ferrglez/solips-hmi-controller/SOLIPS_HMI_CONTROLLER_REV_A/report.txt

Info: Procesando el símbolo 'C1:Capacitor_SMD:C_0805_2012Metric'.
Info: Procesando el símbolo 'R2:Resistor_SMD:R_0603_1608Metric'.
Info: Procesando el símbolo 'C10:Capacitor_SMD:C_0805_2012Metric'.
Info: Procesando el símbolo 'J3:Connector_USB:USB_C_Receptacle_Amphenol_124019772112A'.
Info: Procesando el símbolo 'C4:Capacitor_SMD:C_0603_1608Metric'.
Info: Procesando el símbolo 'R1:Resistor_SMD:R_0603_1608Metric'.
Info: Procesando el símbolo 'C11:Capacitor_SMD:C_1206_3216Metric'.
Info: Procesando el símbolo 'J1:Connector_PinHeader_2.54mm:PinHeader_1x05_P2.54mm_Vertical'.
Info: Procesando el símbolo 'R4:Resistor_SMD:R_0603_1608Metric'.
Info: Procesando el símbolo 'C3:Capacitor_SMD:C_0603_1608Metric'.
Info: Procesando el símbolo 'R3:Resistor_SMD:R_0603_1608Metric'.
Info: Procesando el símbolo 'C12:Capacitor_SMD:C_0805_2012Metric'.
Info: Procesando el símbolo 'C7:Capacitor_SMD:C_0805_2012Metric'.
Info: Procesando el símbolo 'C8:Capacitor_SMD:C_0603_1608Metric'.
Info: Procesando el símbolo 'C2:Capacitor_SMD:C_0603_1608Metric'.
Info: Procesando el símbolo 'C6:Capacitor_SMD:C_0805_2012Metric'.
Info: Procesando el símbolo 'C9:Capacitor_SMD:C_0805_2012Metric'.
Info: Procesando el símbolo 'J4:Connector_PinHeader_2.54mm:PinHeader_1x07_P2.54mm_Vertical'.
Info: Procesando el símbolo 'C5:Capacitor_SMD:C_0603_1608Metric'.
Info: Procesando el símbolo 'R5:Resistor_SMD:R_0603_1608Metric'.
Info: Procesando el símbolo 'R6:Resistor_SMD:R_0603_1608Metric'.
Info: Procesando el símbolo 'R7:Resistor_SMD:R_0603_1608Metric'.
Info: Procesando el símbolo 'R8:Resistor_SMD:R_0603_1608Metric'.
Info: Procesando el símbolo 'SW1:Button_Switch_SMD:SW_SPST_TL3305A'.
Info: Procesando el símbolo 'SW2:Button_Switch_SMD:SW_SPST_TL3305A'.
Info: Procesando el símbolo 'TP1:TestPoint:TestPoint_Pad_D1.5mm'.
Info: Procesando el símbolo 'TP2:TestPoint:TestPoint_Pad_D1.5mm'.
Info: Procesando el símbolo 'U1:Package_QFP:LQFP-48_7x7mm_P0.5mm'.
Info: Procesando el símbolo 'U2:Package_DFN_QFN:WQFN-24-1EP_4x4mm_P0.5mm_EP2.45x2.45mm'.
Info: Procesando el símbolo 'U3:Package_TO_SOT_SMD:SOT-23-6'.
Info: Procesando el símbolo 'U4:Package_TO_SOT_SMD:SOT-23-5'.
Se actualizaron los metadatos de unidad de C1.
Agregado C2 (huella 'Capacitor_SMD:C_0603_1608Metric').
Indicador de referencia cambiado de REF** a C2.
Valor C2 cambiado de C_0603_1608Metric a 100nF.
Asociación de símbolos C2 actualizada de  a /c9596c98-fdf7-4d75-8495-f3fe434cbf88/4467eb84-ecfb-4cf1-84c4-427a7b52d25b.
Actualizar campos C2.
Se actualizó el nombre de la hoja C2 a '/03_MCu/'.
Se actualizó el archivo de hoja C2 a '03_MCU.kicad_sch'.
Se actualizaron los filtros de huella de C2 a 'C_*'.
C2 pin 2 conectado a GND.
Agregar red +3V3.
C2 pin 1 conectado a +3V3.
Se actualizaron los metadatos de unidad de C2.
Agregado C3 (huella 'Capacitor_SMD:C_0603_1608Metric').
Indicador de referencia cambiado de REF** a C3.
Valor C3 cambiado de C_0603_1608Metric a 100nF.
Asociación de símbolos C3 actualizada de  a /c9596c98-fdf7-4d75-8495-f3fe434cbf88/b110ddbe-f6ca-42ca-a978-9b14236cfb37.
Actualizar campos C3.
Se actualizó el nombre de la hoja C3 a '/03_MCu/'.
Se actualizó el archivo de hoja C3 a '03_MCU.kicad_sch'.
Se actualizaron los filtros de huella de C3 a 'C_*'.
C3 pin 2 conectado a GND.
C3 pin 1 conectado a +3V3.
Se actualizaron los metadatos de unidad de C3.
Agregado C4 (huella 'Capacitor_SMD:C_0603_1608Metric').
Indicador de referencia cambiado de REF** a C4.
Valor C4 cambiado de C_0603_1608Metric a 100nF.
Asociación de símbolos C4 actualizada de  a /c9596c98-fdf7-4d75-8495-f3fe434cbf88/4eccbd7d-c71d-49d9-a82d-66c9b8987479.
Actualizar campos C4.
Se actualizó el nombre de la hoja C4 a '/03_MCu/'.
Se actualizó el archivo de hoja C4 a '03_MCU.kicad_sch'.
Se actualizaron los filtros de huella de C4 a 'C_*'.
C4 pin 2 conectado a GND.
C4 pin 1 conectado a +3V3.
Se actualizaron los metadatos de unidad de C4.
Agregado C5 (huella 'Capacitor_SMD:C_0603_1608Metric').
Indicador de referencia cambiado de REF** a C5.
Valor C5 cambiado de C_0603_1608Metric a 100nF.
Asociación de símbolos C5 actualizada de  a /c9596c98-fdf7-4d75-8495-f3fe434cbf88/e27b0a31-f71d-4fdd-a2e6-24cbac124ba2.
Actualizar campos C5.
Se actualizó el nombre de la hoja C5 a '/03_MCu/'.
Se actualizó el archivo de hoja C5 a '03_MCU.kicad_sch'.
Se actualizaron los filtros de huella de C5 a 'C_*'.
C5 pin 1 conectado a +3V3.
C5 pin 2 conectado a GND.
Se actualizaron los metadatos de unidad de C5.
Agregado C6 (huella 'Capacitor_SMD:C_0805_2012Metric').
Indicador de referencia cambiado de REF** a C6.
Valor C6 cambiado de C_0805_2012Metric a 1uF.
Asociación de símbolos C6 actualizada de  a /c9596c98-fdf7-4d75-8495-f3fe434cbf88/558f496c-9939-44e3-b908-68f146186542.
Actualizar campos C6.
Se actualizó el nombre de la hoja C6 a '/03_MCu/'.
Se actualizó el archivo de hoja C6 a '03_MCU.kicad_sch'.
Se actualizaron los filtros de huella de C6 a 'C_*'.
C6 pin 2 conectado a GND.
C6 pin 1 conectado a +3V3.
Se actualizaron los metadatos de unidad de C6.
Agregado C7 (huella 'Capacitor_SMD:C_0805_2012Metric').
Indicador de referencia cambiado de REF** a C7.
Valor C7 cambiado de C_0805_2012Metric a 4.7uF.
Asociación de símbolos C7 actualizada de  a /10d1682a-05b3-42fa-9511-bffc82f69c43/6c540aa3-2eca-4c6d-95e5-621262be4033.
Actualizar campos C7.
Se actualizó el nombre de la hoja C7 a '/02_USB_UART/'.
Se actualizó el archivo de hoja C7 a '02_USB_UART.kicad_sch'.
Se actualizaron los filtros de huella de C7 a 'C_*'.
Agregar red Net-(U2-VDD).
C7 pin 1 conectado a Net-(U2-VDD).
C7 pin 2 conectado a GND.
Se actualizaron los metadatos de unidad de C7.
Agregado C8 (huella 'Capacitor_SMD:C_0603_1608Metric').
Indicador de referencia cambiado de REF** a C8.
Valor C8 cambiado de C_0603_1608Metric a 100nF.
Asociación de símbolos C8 actualizada de  a /10d1682a-05b3-42fa-9511-bffc82f69c43/0269db98-f0dd-4d1b-8dcd-9299b7fe84f5.
Actualizar campos C8.
Se actualizó el nombre de la hoja C8 a '/02_USB_UART/'.
Se actualizó el archivo de hoja C8 a '02_USB_UART.kicad_sch'.
Se actualizaron los filtros de huella de C8 a 'C_*'.
C8 pin 1 conectado a Net-(U2-VDD).
C8 pin 2 conectado a GND.
Se actualizaron los metadatos de unidad de C8.
Agregado C9 (huella 'Capacitor_SMD:C_0805_2012Metric').
Indicador de referencia cambiado de REF** a C9.
Valor C9 cambiado de C_0805_2012Metric a 1µF.
Asociación de símbolos C9 actualizada de  a /05ec0a5c-9647-4b40-9959-19c73f5866a7/4eaefc70-4bc0-49f3-a873-1f2ae664b8bd.
Actualizar campos C9.
Se actualizó el nombre de la hoja C9 a '/01_POWER/'.
Se actualizó el archivo de hoja C9 a '01_POWER.kicad_sch'.
Se actualizaron los filtros de huella de C9 a 'C_*'.
Agregar red /02_USB_UART/USB_5V.
C9 pin 1 conectado a /02_USB_UART/USB_5V.
C9 pin 2 conectado a GND.
Se actualizaron los metadatos de unidad de C9.
Agregado C10 (huella 'Capacitor_SMD:C_0805_2012Metric').
Indicador de referencia cambiado de REF** a C10.
Valor C10 cambiado de C_0805_2012Metric a 1µF.
Asociación de símbolos C10 actualizada de  a /05ec0a5c-9647-4b40-9959-19c73f5866a7/1309739f-1510-4438-ae39-c69c16b107db.
Actualizar campos C10.
Se actualizó el nombre de la hoja C10 a '/01_POWER/'.
Se actualizó el archivo de hoja C10 a '01_POWER.kicad_sch'.
Se actualizaron los filtros de huella de C10 a 'C_*'.
C10 pin 1 conectado a +3V3.
C10 pin 2 conectado a GND.
Se actualizaron los metadatos de unidad de C10.
Agregado C11 (huella 'Capacitor_SMD:C_1206_3216Metric').
Indicador de referencia cambiado de REF** a C11.
Valor C11 cambiado de C_1206_3216Metric a 10uF.
Asociación de símbolos C11 actualizada de  a /c9596c98-fdf7-4d75-8495-f3fe434cbf88/3b9706d6-e7e8-4725-ad99-d57124ee87f7.
Actualizar campos C11.
Se actualizó el nombre de la hoja C11 a '/03_MCu/'.
Se actualizó el archivo de hoja C11 a '03_MCU.kicad_sch'.
Se actualizaron los filtros de huella de C11 a 'C_*'.
C11 pin 1 conectado a +3V3.
C11 pin 2 conectado a GND.
Se actualizaron los metadatos de unidad de C11.
Agregado C12 (huella 'Capacitor_SMD:C_0805_2012Metric').
Indicador de referencia cambiado de REF** a C12.
Valor C12 cambiado de C_0805_2012Metric a 4.7 µF.
Asociación de símbolos C12 actualizada de  a /10d1682a-05b3-42fa-9511-bffc82f69c43/97adc146-8964-4bae-ac5f-eecab92c6020.
Actualizar campos C12.
Se actualizó el nombre de la hoja C12 a '/02_USB_UART/'.
Se actualizó el archivo de hoja C12 a '02_USB_UART.kicad_sch'.
Se actualizaron los filtros de huella de C12 a 'C_*'.
C12 pin 2 conectado a /02_USB_UART/USB_5V.
C12 pin 1 conectado a GND.
Se actualizaron los metadatos de unidad de C12.
Agregado J1 (huella 'Connector_PinHeader_2.54mm:PinHeader_1x05_P2.54mm_Vertical').
Indicador de referencia cambiado de REF** a J1.
Valor J1 cambiado de PinHeader_1x05_P2.54mm_Vertical a Conn_01x05.
Asociación de símbolos J1 actualizada de  a /52f34958-c7fc-4581-a423-01bfa8e8f7c7/80e87493-2f8c-48ec-b9cd-21fb4aaffa53.
Actualizar campos J1.
Se actualizó el nombre de la hoja J1 a '/05_DEBUG/'.
Se actualizó el archivo de hoja J1 a '05_DEBUG.kicad_sch'.
Se actualizaron los filtros de huella de J1 a 'Connector*:*_1x??_*'.
J1 pin 5 conectado a GND.
Agregar red /03_MCu/MCU_NRST.
J1 pin 3 conectado a /03_MCu/MCU_NRST.
J1 pin 1 conectado a +3V3.
J1 pin 4 conectado a /03_MCu/MCU_NRST.
Agregar red /03_MCu/MCU_SWDIO.
J1 pin 2 conectado a /03_MCu/MCU_SWDIO.
Se actualizaron los metadatos de unidad de J1.
Agregado J3 (huella 'Connector_USB:USB_C_Receptacle_Amphenol_124019772112A').
Indicador de referencia cambiado de REF** a J3.
Valor J3 cambiado de USB_C_Receptacle_Amphenol_124019772112A a USB_C_Receptacle_USB2.0_16P.
Asociación de símbolos J3 actualizada de  a /10d1682a-05b3-42fa-9511-bffc82f69c43/e2037769-6a5f-4891-9a21-10af92cf296b.
Actualizar campos J3.
Se actualizó el nombre de la hoja J3 a '/02_USB_UART/'.
Se actualizó el archivo de hoja J3 a '02_USB_UART.kicad_sch'.
Se actualizaron los filtros de huella de J3 a 'USB*C*Receptacle*'.
Agregar red Net-(J3-SHIELD).
J3 pin SH conectado a Net-(J3-SHIELD).
J3 pin A12 conectado a GND.
Agregar red /02_USB_UART/USB_DP_RAW.
J3 pin A6 conectado a /02_USB_UART/USB_DP_RAW.
J3 pin B4 conectado a /02_USB_UART/USB_5V.
J3 pin SH conectado a Net-(J3-SHIELD).
J3 pin B12 conectado a GND.
J3 pin B1 conectado a GND.
J3 pin SH conectado a Net-(J3-SHIELD).
J3 pin A1 conectado a GND.
J3 pin B9 conectado a /02_USB_UART/USB_5V.
J3 pin A1 conectado a GND.
Agregar red /02_USB_UART/USB_DM_RAW.
J3 pin B7 conectado a /02_USB_UART/USB_DM_RAW.
Agregar red Net-(J3-CC2).
J3 pin B5 conectado a Net-(J3-CC2).
J3 pin A4 conectado a /02_USB_UART/USB_5V.
J3 pin B6 conectado a /02_USB_UART/USB_DP_RAW.
J3 pin A7 conectado a /02_USB_UART/USB_DM_RAW.
Agregar red unconnected-(J3-SBU1-PadA8).
J3 pin A8 conectado a unconnected-(J3-SBU1-PadA8).
Agregar red Net-(J3-CC1).
J3 pin A5 conectado a Net-(J3-CC1).
J3 pin A9 conectado a /02_USB_UART/USB_5V.
J3 pin A1 conectado a GND.
Agregar red unconnected-(J3-SBU2-PadB8).
J3 pin B8 conectado a unconnected-(J3-SBU2-PadB8).
J3 pin SH conectado a Net-(J3-SHIELD).
Se actualizaron los metadatos de unidad de J3.
Agregado J4 (huella 'Connector_PinHeader_2.54mm:PinHeader_1x07_P2.54mm_Vertical').
Indicador de referencia cambiado de REF** a J4.
Valor J4 cambiado de PinHeader_1x07_P2.54mm_Vertical a Conn_01x07.
Asociación de símbolos J4 actualizada de  a /36965fbf-a33d-4165-b521-3099ad8b80c5/500bb09e-58cf-4d2a-8b7e-7a604f7db37f.
Actualizar campos J4.
Se actualizó el nombre de la hoja J4 a '/04_DISPLAY/'.
Se actualizó el archivo de hoja J4 a '04_DISPLAY.kicad_sch'.
Se actualizaron los filtros de huella de J4 a 'Connector*:*_1x??_*'.
Agregar red /03_MCu/TFT_DC.
J4 pin 3 conectado a /03_MCu/TFT_DC.
Agregar red /03_MCu/TFT_CS.
J4 pin 2 conectado a /03_MCu/TFT_CS.
J4 pin 7 conectado a +3V3.
Agregar red /03_MCu/TFT_RST.
J4 pin 1 conectado a /03_MCu/TFT_RST.
Agregar red /03_MCu/TFT_SCK.
J4 pin 5 conectado a /03_MCu/TFT_SCK.
Agregar red /03_MCu/TFT_MOSI.
J4 pin 4 conectado a /03_MCu/TFT_MOSI.
J4 pin 6 conectado a GND.
Se actualizaron los metadatos de unidad de J4.
Agregado R1 (huella 'Resistor_SMD:R_0603_1608Metric').
Indicador de referencia cambiado de REF** a R1.
Valor R1 cambiado de R_0603_1608Metric a 5.1kΩ.
Asociación de símbolos R1 actualizada de  a /10d1682a-05b3-42fa-9511-bffc82f69c43/d86a4afc-83fd-47d1-a282-f2a20b003bf0.
Actualizar campos R1.
Se actualizó el nombre de la hoja R1 a '/02_USB_UART/'.
Se actualizó el archivo de hoja R1 a '02_USB_UART.kicad_sch'.
Se actualizaron los filtros de huella de R1 a 'R_*'.
R1 pin 2 conectado a GND.
R1 pin 1 conectado a Net-(J3-CC1).
Se actualizaron los metadatos de unidad de R1.
Agregado R2 (huella 'Resistor_SMD:R_0603_1608Metric').
Indicador de referencia cambiado de REF** a R2.
Valor R2 cambiado de R_0603_1608Metric a 5.1kΩ.
Asociación de símbolos R2 actualizada de  a /10d1682a-05b3-42fa-9511-bffc82f69c43/045c840a-41a6-4b2d-9a2f-736c85ee160f.
Actualizar campos R2.
Se actualizó el nombre de la hoja R2 a '/02_USB_UART/'.
Se actualizó el archivo de hoja R2 a '02_USB_UART.kicad_sch'.
Se actualizaron los filtros de huella de R2 a 'R_*'.
R2 pin 1 conectado a Net-(J3-CC2).
R2 pin 2 conectado a GND.
Se actualizaron los metadatos de unidad de R2.
Agregado R3 (huella 'Resistor_SMD:R_0603_1608Metric').
Indicador de referencia cambiado de REF** a R3.
Valor R3 cambiado de R_0603_1608Metric a 1 kΩ..
Asociación de símbolos R3 actualizada de  a /10d1682a-05b3-42fa-9511-bffc82f69c43/2c78aa09-c2a2-4112-bed1-f35b3e5da059.
Actualizar campos R3.
Se actualizó el nombre de la hoja R3 a '/02_USB_UART/'.
Se actualizó el archivo de hoja R3 a '02_USB_UART.kicad_sch'.
Se actualizaron los filtros de huella de R3 a 'R_*'.
R3 pin 1 conectado a +3V3.
Agregar red Net-(U2-~{RST}).
R3 pin 2 conectado a Net-(U2-~{RST}).
Se actualizaron los metadatos de unidad de R3.
Agregado R4 (huella 'Resistor_SMD:R_0603_1608Metric').
Indicador de referencia cambiado de REF** a R4.
Valor R4 cambiado de R_0603_1608Metric a 47.5 kΩ.
Asociación de símbolos R4 actualizada de  a /10d1682a-05b3-42fa-9511-bffc82f69c43/89a8b54f-9642-41f3-a8d0-0a24f1d9ca9f.
Actualizar campos R4.
Se actualizó el nombre de la hoja R4 a '/02_USB_UART/'.
Se actualizó el archivo de hoja R4 a '02_USB_UART.kicad_sch'.
Se actualizaron los filtros de huella de R4 a 'R_*'.
Agregar red Net-(U2-VBUS).
R4 pin 1 conectado a Net-(U2-VBUS).
R4 pin 2 conectado a GND.
Se actualizaron los metadatos de unidad de R4.
Agregado C1 (huella 'Capacitor_SMD:C_0805_2012Metric').
Agregado R5 (huella 'Resistor_SMD:R_0603_1608Metric').
Indicador de referencia cambiado de REF** a R5.
Valor R5 cambiado de R_0603_1608Metric a 22.1 kΩ.
Asociación de símbolos R5 actualizada de  a /10d1682a-05b3-42fa-9511-bffc82f69c43/1ad5ebd5-f28f-4570-a034-687edf8bbf4e.
Actualizar campos R5.
Se actualizó el nombre de la hoja R5 a '/02_USB_UART/'.
Se actualizó el archivo de hoja R5 a '02_USB_UART.kicad_sch'.
Se actualizaron los filtros de huella de R5 a 'R_*'.
R5 pin 1 conectado a /02_USB_UART/USB_5V.
R5 pin 2 conectado a Net-(U2-VBUS).
Se actualizaron los metadatos de unidad de R5.
Indicador de referencia cambiado de REF** a C1.
Agregado R6 (huella 'Resistor_SMD:R_0603_1608Metric').
Indicador de referencia cambiado de REF** a R6.
Valor R6 cambiado de R_0603_1608Metric a 10 kΩ.
Asociación de símbolos R6 actualizada de  a /c9596c98-fdf7-4d75-8495-f3fe434cbf88/b94767d8-f876-4931-a6f4-e93131fd67a2.
Actualizar campos R6.
Se actualizó el nombre de la hoja R6 a '/03_MCu/'.
Se actualizó el archivo de hoja R6 a '03_MCU.kicad_sch'.
Se actualizaron los filtros de huella de R6 a 'R_*'.
Agregar red /03_MCu/MCU_BOOT0.
R6 pin 1 conectado a /03_MCu/MCU_BOOT0.
R6 pin 2 conectado a GND.
Se actualizaron los metadatos de unidad de R6.
Valor C1 cambiado de C_0805_2012Metric a 4.7uF.
Agregado R7 (huella 'Resistor_SMD:R_0603_1608Metric').
Indicador de referencia cambiado de REF** a R7.
Valor R7 cambiado de R_0603_1608Metric a 10 kΩ.
Asociación de símbolos R7 actualizada de  a /c9596c98-fdf7-4d75-8495-f3fe434cbf88/6222ba3e-22f1-4460-8366-db9ca03a3931.
Actualizar campos R7.
Se actualizó el nombre de la hoja R7 a '/03_MCu/'.
Se actualizó el archivo de hoja R7 a '03_MCU.kicad_sch'.
Se actualizaron los filtros de huella de R7 a 'R_*'.
R7 pin 1 conectado a +3V3.
R7 pin 2 conectado a /03_MCu/MCU_NRST.
Se actualizaron los metadatos de unidad de R7.
Asociación de símbolos C1 actualizada de  a /c9596c98-fdf7-4d75-8495-f3fe434cbf88/3c516959-7373-410b-9f42-0ec5df99c3b7.
Agregado R8 (huella 'Resistor_SMD:R_0603_1608Metric').
Indicador de referencia cambiado de REF** a R8.
Valor R8 cambiado de R_0603_1608Metric a 0Ω.
Asociación de símbolos R8 actualizada de  a /10d1682a-05b3-42fa-9511-bffc82f69c43/31d9ffe7-0b9d-4d8a-a4c5-139ff4f25ca7.
Actualizar campos R8.
Se actualizó el nombre de la hoja R8 a '/02_USB_UART/'.
Se actualizó el archivo de hoja R8 a '02_USB_UART.kicad_sch'.
Se actualizaron los filtros de huella de R8 a 'R_*'.
R8 pin 2 conectado a GND.
R8 pin 1 conectado a Net-(J3-SHIELD).
Se actualizaron los metadatos de unidad de R8.
Actualizar campos C1.
Agregado SW1 (huella 'Button_Switch_SMD:SW_SPST_TL3305A').
Indicador de referencia cambiado de REF** a SW1.
Valor SW1 cambiado de SW_SPST_TL3305A a RESET.
Asociación de símbolos SW1 actualizada de  a /52f34958-c7fc-4581-a423-01bfa8e8f7c7/fa9f9bd7-4056-470e-9405-bc01834a4544.
Actualizar campos SW1.
Se actualizó el nombre de la hoja SW1 a '/05_DEBUG/'.
Se actualizó el archivo de hoja SW1 a '05_DEBUG.kicad_sch'.
SW1 pin 2 conectado a /03_MCu/MCU_NRST.
SW1 pin 1 conectado a GND.
SW1 pin 2 conectado a /03_MCu/MCU_NRST.
SW1 pin 1 conectado a GND.
Se actualizaron los metadatos de unidad de SW1.
Se actualizó el nombre de la hoja C1 a '/03_MCu/'.
Agregado SW2 (huella 'Button_Switch_SMD:SW_SPST_TL3305A').
Indicador de referencia cambiado de REF** a SW2.
Valor SW2 cambiado de SW_SPST_TL3305A a BOOT.
Asociación de símbolos SW2 actualizada de  a /52f34958-c7fc-4581-a423-01bfa8e8f7c7/e7996f73-939a-448f-8e6a-ac38d1d052b1.
Actualizar campos SW2.
Se actualizó el nombre de la hoja SW2 a '/05_DEBUG/'.
Se actualizó el archivo de hoja SW2 a '05_DEBUG.kicad_sch'.
SW2 pin 1 conectado a +3V3.
SW2 pin 2 conectado a /03_MCu/MCU_BOOT0.
SW2 pin 2 conectado a /03_MCu/MCU_BOOT0.
SW2 pin 1 conectado a +3V3.
Se actualizaron los metadatos de unidad de SW2.
Se actualizó el archivo de hoja C1 a '03_MCU.kicad_sch'.
Agregado TP1 (huella 'TestPoint:TestPoint_Pad_D1.5mm').
Indicador de referencia cambiado de REF** a TP1.
Valor TP1 cambiado de TestPoint_Pad_D1.5mm a USB_UART_DTR.
Asociación de símbolos TP1 actualizada de  a /10d1682a-05b3-42fa-9511-bffc82f69c43/7932365a-2581-4fb5-8753-500ff6cb298c.
Actualizar campos TP1.
Se actualizó el nombre de la hoja TP1 a '/02_USB_UART/'.
Se actualizó el archivo de hoja TP1 a '02_USB_UART.kicad_sch'.
Se actualizaron los filtros de huella de TP1 a 'Pin* Test*'.
Atributo de fabricación 'excluir de la lista de materiales' TP1 eliminado.
Atributo de fabricación 'excluir de los archivos de posición' TP1 eliminado.
Agregar red /02_USB_UART/USB_UART_DTR.
TP1 pin 1 conectado a /02_USB_UART/USB_UART_DTR.
Se actualizaron los metadatos de unidad de TP1.
Se actualizaron los filtros de huella de C1 a 'C_*'.
Agregado TP2 (huella 'TestPoint:TestPoint_Pad_D1.5mm').
Indicador de referencia cambiado de REF** a TP2.
Valor TP2 cambiado de TestPoint_Pad_D1.5mm a USB_UART_RTS.
Asociación de símbolos TP2 actualizada de  a /10d1682a-05b3-42fa-9511-bffc82f69c43/f6456a7f-2577-4b5d-9dcd-045762bf04c7.
Actualizar campos TP2.
Se actualizó el nombre de la hoja TP2 a '/02_USB_UART/'.
Se actualizó el archivo de hoja TP2 a '02_USB_UART.kicad_sch'.
Se actualizaron los filtros de huella de TP2 a 'Pin* Test*'.
Atributo de fabricación 'excluir de la lista de materiales' TP2 eliminado.
Atributo de fabricación 'excluir de los archivos de posición' TP2 eliminado.
Agregar red /02_USB_UART/USB_UART_RTS.
TP2 pin 1 conectado a /02_USB_UART/USB_UART_RTS.
Se actualizaron los metadatos de unidad de TP2.
Agregar red GND.
Agregado U1 (huella 'Package_QFP:LQFP-48_7x7mm_P0.5mm').
Indicador de referencia cambiado de REF** a U1.
Valor U1 cambiado de LQFP-48_7x7mm_P0.5mm a STM32U585CITx.
Asociación de símbolos U1 actualizada de  a /c9596c98-fdf7-4d75-8495-f3fe434cbf88/a42c4cd9-bdb5-46f7-b2ec-d2c32b1a609e.
Actualizar campos U1.
Se actualizó el nombre de la hoja U1 a '/03_MCu/'.
Se actualizó el archivo de hoja U1 a '03_MCU.kicad_sch'.
Se actualizaron los filtros de huella de U1 a 'LQFP*7x7mm*P0.5mm*'.
U1 pin 24 conectado a +3V3.
U1 pin 22 conectado a Net-(U1-VCAP).
Agregar red unconnected-(U1-PC15-Pad4).
U1 pin 4 conectado a unconnected-(U1-PC15-Pad4).
Agregar red /02_USB_UART/MCU_UART_TX.
U1 pin 30 conectado a /02_USB_UART/MCU_UART_TX.
Agregar red unconnected-(U1-PA1-Pad11).
U1 pin 11 conectado a unconnected-(U1-PA1-Pad11).
Agregar red unconnected-(U1-PA3-Pad13).
U1 pin 13 conectado a unconnected-(U1-PA3-Pad13).
U1 pin 1 conectado a +3V3.
Agregar red unconnected-(U1-PB14-Pad27).
U1 pin 27 conectado a unconnected-(U1-PB14-Pad27).
U1 pin 19 conectado a /03_MCu/TFT_DC.
U1 pin 9 conectado a +3V3.
Agregar red unconnected-(U1-PB3-Pad39).
U1 pin 39 conectado a unconnected-(U1-PB3-Pad39).
U1 pin 18 conectado a /03_MCu/TFT_CS.
U1 pin 17 conectado a /03_MCu/TFT_MOSI.
Agregar red unconnected-(U1-PA6-Pad16).
U1 pin 16 conectado a unconnected-(U1-PA6-Pad16).
Agregar red unconnected-(U1-PB4-Pad40).
U1 pin 40 conectado a unconnected-(U1-PB4-Pad40).
Agregar red unconnected-(U1-PH0-Pad5).
U1 pin 5 conectado a unconnected-(U1-PH0-Pad5).
Agregar red unconnected-(U1-PA2-Pad12).
U1 pin 12 conectado a unconnected-(U1-PA2-Pad12).
Agregar red unconnected-(U1-PC14-Pad3).
U1 pin 3 conectado a unconnected-(U1-PC14-Pad3).
U1 pin 48 conectado a +3V3.
U1 pin 8 conectado a GND.
Agregar red unconnected-(U1-PA12-Pad33).
U1 pin 33 conectado a unconnected-(U1-PA12-Pad33).
Agregar red unconnected-(U1-PH1-Pad6).
U1 pin 6 conectado a unconnected-(U1-PH1-Pad6).
Agregar red unconnected-(U1-PA0-Pad10).
U1 pin 10 conectado a unconnected-(U1-PA0-Pad10).
Agregar red unconnected-(U1-PA4-Pad14).
U1 pin 14 conectado a unconnected-(U1-PA4-Pad14).
Agregar red /02_USB_UART/MCU_UART_RX.
U1 pin 31 conectado a /02_USB_UART/MCU_UART_RX.
Agregar red unconnected-(U1-PB8-Pad45).
U1 pin 45 conectado a unconnected-(U1-PB8-Pad45).
Agregar red unconnected-(U1-PB9-Pad46).
U1 pin 46 conectado a unconnected-(U1-PB9-Pad46).
Agregar red unconnected-(U1-PA11-Pad32).
U1 pin 32 conectado a unconnected-(U1-PA11-Pad32).
Agregar red unconnected-(U1-PB12-Pad25).
U1 pin 25 conectado a unconnected-(U1-PB12-Pad25).
Agregar red unconnected-(U1-PB13-Pad26).
U1 pin 26 conectado a unconnected-(U1-PB13-Pad26).
U1 pin 23 conectado a GND.
U1 pin 20 conectado a /03_MCu/TFT_RST.
U1 pin 7 conectado a /03_MCu/MCU_NRST.
U1 pin 44 conectado a /03_MCu/MCU_BOOT0.
Agregar red unconnected-(U1-PB15-Pad28).
U1 pin 28 conectado a unconnected-(U1-PB15-Pad28).
U1 pin 47 conectado a GND.
U1 pin 15 conectado a /03_MCu/TFT_SCK.
U1 pin 34 conectado a /03_MCu/MCU_SWDIO.
Agregar red unconnected-(U1-PC13-Pad2).
U1 pin 2 conectado a unconnected-(U1-PC13-Pad2).
Agregar red unconnected-(U1-PB5-Pad41).
U1 pin 41 conectado a unconnected-(U1-PB5-Pad41).
Agregar red unconnected-(U1-PB10-Pad21).
U1 pin 21 conectado a unconnected-(U1-PB10-Pad21).
Agregar red unconnected-(U1-PA15-Pad38).
U1 pin 38 conectado a unconnected-(U1-PA15-Pad38).
Agregar red unconnected-(U1-PA8-Pad29).
U1 pin 29 conectado a unconnected-(U1-PA8-Pad29).
Agregar red unconnected-(U1-PB7-Pad43).
U1 pin 43 conectado a unconnected-(U1-PB7-Pad43).
U1 pin 35 conectado a GND.
U1 pin 37 conectado a /03_MCu/MCU_NRST.
U1 pin 36 conectado a +3V3.
Agregar red unconnected-(U1-PB6-Pad42).
U1 pin 42 conectado a unconnected-(U1-PB6-Pad42).
Se actualizaron los metadatos de unidad de U1.
C1 pin 2 conectado a GND.
Agregado U2 (huella 'Package_DFN_QFN:WQFN-24-1EP_4x4mm_P0.5mm_EP2.45x2.45mm').
Indicador de referencia cambiado de REF** a U2.
Valor U2 cambiado de WQFN-24-1EP_4x4mm_P0.5mm_EP2.45x2.45mm a CP2102C-Axx-xQFN24.
Asociación de símbolos U2 actualizada de  a /10d1682a-05b3-42fa-9511-bffc82f69c43/362324eb-469b-4e42-9e21-ad3ebacc6113.
Actualizar campos U2.
Se actualizó el nombre de la hoja U2 a '/02_USB_UART/'.
Se actualizó el archivo de hoja U2 a '02_USB_UART.kicad_sch'.
Se actualizaron los filtros de huella de U2 a '*QFN*4x4mm?P0.5mm?EP2.45x2.45mm*'.
Agregar red unconnected-(U2-NC-Pad10).
U2 pin 10 conectado a unconnected-(U2-NC-Pad10).
Agregar red unconnected-(U2-~{DSR}-Pad22).
U2 pin 22 conectado a unconnected-(U2-~{DSR}-Pad22).
Agregar red /02_USB_UART/USB_DM.
U2 pin 4 conectado a /02_USB_UART/USB_DM.
U2 pin 20 conectado a /02_USB_UART/MCU_UART_TX.
U2 pin 8 conectado a Net-(U2-VBUS).
Agregar red /02_USB_UART/USB_DP.
U2 pin 3 conectado a /02_USB_UART/USB_DP.
U2 pin 25 conectado a GND.
U2 pin 23 conectado a /02_USB_UART/USB_UART_DTR.
Agregar red unconnected-(U2-NC-Pad13).
U2 pin 13 conectado a unconnected-(U2-NC-Pad13).
Agregar red unconnected-(U2-~{SUSPEND}-Pad15).
U2 pin 15 conectado a unconnected-(U2-~{SUSPEND}-Pad15).
Agregar red unconnected-(U2-~{CTS}-Pad18).
U2 pin 18 conectado a unconnected-(U2-~{CTS}-Pad18).
U2 pin 6 conectado a Net-(U2-VDD).
Agregar red unconnected-(U2-~{DCD}-Pad24).
U2 pin 24 conectado a unconnected-(U2-~{DCD}-Pad24).
U2 pin 19 conectado a /02_USB_UART/USB_UART_RTS.
Agregar red unconnected-(U2-NC-Pad16).
U2 pin 16 conectado a unconnected-(U2-NC-Pad16).
Agregar red unconnected-(U2-SUSPEND-Pad17).
U2 pin 17 conectado a unconnected-(U2-SUSPEND-Pad17).
U2 pin 21 conectado a /02_USB_UART/MCU_UART_RX.
U2 pin 7 conectado a /02_USB_UART/USB_5V.
Agregar red unconnected-(U2-NC-Pad12).
U2 pin 12 conectado a unconnected-(U2-NC-Pad12).
U2 pin 2 conectado a GND.
U2 pin 5 conectado a +3V3.
Agregar red unconnected-(U2-~{RI}-Pad1).
U2 pin 1 conectado a unconnected-(U2-~{RI}-Pad1).
Agregar red unconnected-(U2-NC-Pad14).
U2 pin 14 conectado a unconnected-(U2-NC-Pad14).
Agregar red unconnected-(U2-NC-Pad11).
U2 pin 11 conectado a unconnected-(U2-NC-Pad11).
U2 pin 9 conectado a Net-(U2-~{RST}).
Se actualizaron los metadatos de unidad de U2.
Agregar red Net-(U1-VCAP).
Agregado U3 (huella 'Package_TO_SOT_SMD:SOT-23-6').
Indicador de referencia cambiado de REF** a U3.
Valor U3 cambiado de SOT-23-6 a USBLC6-2SC6.
Asociación de símbolos U3 actualizada de  a /10d1682a-05b3-42fa-9511-bffc82f69c43/82571e3c-b101-42a2-b111-9a31394e95ef.
Actualizar campos U3.
Se actualizó el nombre de la hoja U3 a '/02_USB_UART/'.
Se actualizó el archivo de hoja U3 a '02_USB_UART.kicad_sch'.
Se actualizaron los filtros de huella de U3 a 'SOT?23*'.
U3 pin 4 conectado a /02_USB_UART/USB_DM.
U3 pin 5 conectado a /02_USB_UART/USB_5V.
U3 pin 6 conectado a /02_USB_UART/USB_DP.
U3 pin 3 conectado a /02_USB_UART/USB_DM_RAW.
U3 pin 1 conectado a /02_USB_UART/USB_DP_RAW.
U3 pin 2 conectado a GND.
Se actualizaron los metadatos de unidad de U3.
C1 pin 1 conectado a Net-(U1-VCAP).
Agregado U4 (huella 'Package_TO_SOT_SMD:SOT-23-5').
Indicador de referencia cambiado de REF** a U4.
Valor U4 cambiado de SOT-23-5 a AP2112K-3.3.
Asociación de símbolos U4 actualizada de  a /05ec0a5c-9647-4b40-9959-19c73f5866a7/7a395f13-8e0a-48b5-b5ad-fdfb52d06bd8.
Actualizar campos U4.
Se actualizó el nombre de la hoja U4 a '/01_POWER/'.
Se actualizó el archivo de hoja U4 a '01_POWER.kicad_sch'.
Se actualizaron los filtros de huella de U4 a 'SOT?23?5*'.
U4 pin 5 conectado a +3V3.
Agregar red unconnected-(U4-NC-Pad4).
U4 pin 4 conectado a unconnected-(U4-NC-Pad4).
U4 pin 1 conectado a /02_USB_UART/USB_5V.
U4 pin 2 conectado a GND.
U4 pin 3 conectado a /02_USB_UART/USB_5V.
Se actualizaron los metadatos de unidad de U4.

Info: Número de avisos: 0, errores: 0.
