ferrglez/solips-hmi-controller/docs/Engineering_Specification.docx

# SOLIPS HMI CONTROLLER REV A — Engineering Requirements & Schematic Specification

Campo | Baseline
Versión / fecha | 1.0 / 30 septiembre 2026
Status | Architecture FROZEN. Engineering baseline para revisión; implementación y validación física pendientes.
Purpose | Fuente de verdad para iniciar el esquemático Rev A en KiCad.
Architecture freeze | UNO Q → USB CDC / CP2102C → USART1 / STM32U585CIT6 → SPI1 + DMA / GC9A01.

# 1 Alcance y control de la baseline

Esta PCB separa físicamente el HMI del Arduino UNO Q. LVGL, UIManager, assets y renderizado consumen recursos que el sistema también necesita para CAN, procesamiento, aplicación y comunicación. UNO Q conserva la lógica del sistema; la PCB HMI ejecuta el controlador gráfico; GC9A01 presenta la interfaz.

REQUIRED: UNO Q no renderiza gráficos ni almacena assets del HMI. Envía información semántica al parser del STM32, que actualiza VehicleState, UIManager y LVGL. QRB reemplaza la simulación actual bakeUpdate.h.

BRAKE,95,OK
ENGINE,92,OK
ETA,102
DISTANCE,120
DELIVERY,IN_TRANSIT
DOCK,12

Los ejemplos no congelan baud rate, unidades, framing, intervalos, timeouts ni política ante pérdida de comunicación: [OPEN ITEM] de firmware, sin impedir comenzar KiCad.

## 1.1 Fuentes y trazabilidad

S1 — Texto pegado(1).txt, investigación adjunta, secciones 1–14 y Design freeze Rev A. S2 — requisitos de esta solicitud, secciones 1–24. S1 es la fuente principal; S2 formaliza y congela sus asignaciones. Los marcadores de citas indexadas de S1 no contienen URLs ni revisiones identificables: no equivalen a datasheets verificados. Registrar documento, revisión, tabla y página al cerrar cada VERIFY.

Estado | Significado
FROZEN | Decisión tomada; no reabrir alternativas.
REQUIRED | Obligación de implementación o prueba.
TO SELECT | Componente pendiente de seleccionar.
VERIFY | Dato o comportamiento que necesita comprobación.
OPEN ITEM | Detalle todavía no cerrado.
FABRICATION GATE | Evidencia obligatoria antes de fabricar.

# 2 Arquitectura congelada

ARDUINO UNO Q / QRB2210 / Debian
| USB 2.0 / USB CDC
CP2102C-A01-GQFN24 [DTR / RTS]
| USART1 @ 3.3 V [PA9 / PA10]
STM32U585CIT6 [VehicleState / UIManager / LVGL 9.5 / assets]
| SPI1 + DMA
GC9A01 [240 x 240 / RGB565]

Bloque | Decisión Rev A — FROZEN
Host | Arduino UNO Q / QRB2210 / Debian
MCU / package | STM32U585CIT6 / LQFP48 / 7×7 mm
CPU / memoria | Cortex-M33 / 160 MHz / Flash 2 MB / SRAM 786 KB
USB-UART / host interface | CP2102C-A01-GQFN24 / USB CDC
MCU serial | USART1: PA9 TX / PA10 RX
Firmware update | STM32 ROM bootloader por USART1
Auto boot / recuperación | DTR + RTS + red de transistores / SWD
Display / bus | GC9A01 240×240 RGB565 / SPI1 + DMA
Lógica / entrada | 3.3 V / USB 5 V
Regulación | LDO 3.3 V ≥500 mA; no buck
PCB | 4 capas
Software | LVGL 9.5 / UIManager existente / VehicleState
Datos | UNO Q reemplaza bakeUpdate.h; host envía semántica

S1 §§1–14 / Design freeze; S2 §2. La variante CIT6 y el bridge CP2102C forman parte de esta baseline. No hay ronda adicional de selección de MCU ni sustitución del bridge.

## 2.1 Integración física con el host

REQUIRED / VERIFY: integrar UNO Q con powered USB-C hub o carrier que preserve alimentación del host y función USB host hacia la PCB. S1 §10 advierte que USB-C del UNO Q también es entrada de alimentación. No dar por validado un cable USB-C directo. Documentar hub/carrier, cable, presupuesto de corriente y ausencia de realimentación en la revisión de integración.

La ejecución previa del HMI sobre un STM32U585 y el tamaño aproximado de 704 KB reportados en S1 §1 no validan esta PCB ni constituyen el presupuesto final de firmware de Rev A. El mapa de memoria y la migración deben verificarse con el build dedicado.

# 3 Requisitos funcionales

ID | Requisito REQUIRED | Componente / señal | Verificación
FR-01 | Ejecutar independientemente el HMI. | U1 + J2 | T08 / T10; render local sin assets del host.
FR-02 | Recibir semántica; host no envía gráficos ni conserva assets. | U2 / USART1 | T11; revisión del protocolo y software host.
FR-03 | Mantener VehicleState en STM32. | U1 / UART1_RX | T11; mensajes conocidos cambian campos esperados.
FR-04 | Ejecutar UIManager existente. | U1 | T10; navegación y estados esperados.
FR-05 | Ejecutar LVGL 9.5. | U1 | T10; versión de build y render.
FR-06 | Controlar GC9A01 por SPI1 + DMA. | PA5 / PA7 / J2 | T09; captura SPI y transferencia DMA.
FR-07 | Migrar las 9 pantallas existentes. | U1 / assets / J2 | T10; checklist por pantalla y transición.
FR-08 | Actualizar Flash mediante ROM bootloader USART1. | U2 / PA9 / PA10 | T05 / T07; programar y verificar imagen.
FR-09 | Recuperar y programar mediante SWD. | PA13 / PA14 / J3 | T04; conexión y recuperación.
FR-10 | Entrar y salir de bootloader automáticamente. | DTR / RTS / PH3 / NRST | T06 / T08; secuencia capturada.
FR-11 | Mantener boot y reset manuales. | BOOT0 access / RESET access | T05; entrada manual sin control del host.
FR-12 | Permitir control del backlight desde PB3. | TFT_BL_PWM | T09; control seguro con módulo exacto.

## 3.1 Requisitos eléctricos y de hardware

ID | Requisito REQUIRED | Verificación
ER-01 | Entrada USB 5 V; lógica 3.3 V. | T01; niveles y tolerancias [VERIFY FROM DATASHEET].
ER-02 | LDO 3.3 V ≥500 mA; validar corriente real y térmica. | Presupuesto de cargas + T01 bajo carga.
ER-03 | USART1 exclusivo para host y ROM bootloader. | Revisión pinout + T03 / T07.
ER-04 | USB-C USB 2.0 device-only, CC independientes y ESD D+/D−. | Revisión J1 / U2 + T02.
ER-05 | Alimentación MCU conforme a package y reference design. | Revisión U1 + T01 / T04.
ER-06 | DTR/RTS mediante red de control; defaults BOOT0 LOW / NRST HIGH. | Tabla lógica + T05 / T06.
ER-07 | 4 capas, retornos continuos y SWD accesible. | Revisión layout / DRC + T04.

# 4 MCU y alimentación

FROZEN — U1 STM32U585CIT6, LQFP48 7×7 mm, Cortex-M33 @160 MHz, Flash 2 MB, SRAM 786 KB. S1 §1 reporta DMA y DMA2D; esta baseline exige SPI1 + DMA y no depende de usar DMA2D. No seleccionar variante con SMPS interno para esta revisión (S1 §8).

## 4.1 Alimentación del MCU

Señal / elemento | Implementación requerida | Valor / cierre
VDD | Conectar todos los VDD del package a +3V3; desacoplo local a GND. | 100 nF por alimentación, según S1 §8; cantidad/pines [VERIFY FROM DATASHEET].
VSS / retorno analógico | Todos los retornos definidos en package a GND. | Enumeración completa, incluido VSSA si aplica: [VERIFY FROM DATASHEET].
VDDA | Alimentación analógica desde dominio 3.3 V conforme a ST; retorno a GND. | 100 nF + 1 µF reportados en S1 §8. Filtrado/conexión exacta [VERIFY FROM DATASHEET].
VCAP | Red dedicada conforme a ST; no tratar como alimentación de cargas externas. | 4.7 µF o 2×2.2 µF según S1 §8. Configuración final, ESR y características [VERIFY FROM DATASHEET].
Bulk MCU | Reservar capacitor bulk cerca del MCU. | Valor, cantidad, tecnología y tensión [VERIFY FROM DATASHEET].
Otros pines de alimentación | Auditar símbolo completo y requisitos de todos los dominios presentes, incluidas referencias y backup si aplica. | Conexiones y tratamiento de dominios no usados [VERIFY FROM DATASHEET].

REQUIRED: cotejar el símbolo KiCad con el pinout de CIT6 LQFP48; no copiar redes de otro package. Los valores reportados en S1 deben cotejarse con la revisión oficial de ST antes del schematic freeze. Registrar referencias C y pin correspondiente; mantener lazo de desacoplo corto y conexión inmediata al plano GND.

## 4.2 Power tree

USB-C VBUS / +5V_USB
+----> TFT supply path* ---> J2
|
+----> U3 LDO 3.3 V >=500 mA ---> +3V3
+--> STM32U585
+--> CP2102C VIO
+--> lógica 3.3 V
* Tensión y circuito dependen del módulo físico: VERIFY.

FROZEN: LDO por simplicidad, menor cantidad de componentes y ausencia de switching noise del regulador; Rev A prioriza bring-up sobre eficiencia máxima. ≥500 mA es capacidad mínima del regulador, no consumo validado ni autorización para extraer esa corriente de cualquier puerto USB.

VERIFY: presupuesto máximo MCU + bridge + display/backlight, arranque e inrush; corriente USB disponible por hub/carrier; disipación del LDO con caída 5 V a 3.3 V y carga real. U3 TO SELECT: comprobar estabilidad, capacitores de entrada/salida, dropout, enable y condiciones térmicas. VCC del display no se congela a 5 V hasta comprobar el módulo exacto.

# 5 Clock y pinout maestro

## 5.1 Clock

OPEN / VERIFY — S1 no define fuente de clock, frecuencia externa, cristal, oscilador, PLL ni RTC. No asignar cristal ni capacitores de carga por suposición. Los 160 MHz congelados son el objetivo de CPU; no determinan por sí solos una frecuencia de cristal.

Antes del schematic freeze: verificar el árbol de clock que alcance 160 MHz en condiciones admitidas por ST; seleccionar explícitamente la fuente interna o implementación externa; cerrar alimentación y voltage scaling; documentar tolerancia requerida para USART1 y SPI1. Si se usa clock externo, cerrar pines, frecuencia, componente y red de carga. RTC/LSE: [OPEN ITEM], indicar si es necesario y su circuito. Confirmar requisitos de clock del ROM bootloader sin asumir que dependen del clock de aplicación.

## 5.2 Asignaciones reservadas FROZEN

MCU signal | Net KiCad | Destino / función | Pin físico
PA9 | UART1_TX | U2 RXD / USART1_TX | [VERIFY FROM DATASHEET]
PA10 | UART1_RX | U2 TXD / USART1_RX | [VERIFY FROM DATASHEET]
PH3 / BOOT0 | HMI_BOOT0 | Red DTR + acceso manual | 44 según S1 §5; VERIFY
NRST | HMI_NRST | Red RTS + reset manual + SWD | 7 según S1 §5; VERIFY
PA13 | SWDIO | J3 / SWDIO | [VERIFY FROM DATASHEET]
PA14 | SWCLK | J3 / SWCLK | [VERIFY FROM DATASHEET]
PA5 | TFT_SCK | J2 / SPI1_SCK | [VERIFY FROM DATASHEET]
PA7 | TFT_MOSI | J2 / SPI1_MOSI | [VERIFY FROM DATASHEET]
PB0 | TFT_CS | J2 / CS | [VERIFY FROM DATASHEET]
PB1 | TFT_DC | J2 / DC | [VERIFY FROM DATASHEET]
PB2 | TFT_RST | J2 / RST | [VERIFY FROM DATASHEET]
PB3 | TFT_BL_PWM | Circuito BL / J2 | [VERIFY FROM DATASHEET]

REQUIRED: confirmar números de terminal y alternate functions para CIT6 antes de cablear el símbolo final. PB3 debe conservar su uso como backlight; verificar función timer/PWM y liberar cualquier función debug conflictiva en firmware manteniendo SWD en PA13/PA14. No reasignar USART1 ni señales congeladas para resolver pendientes.

# 6 BOOT0 RESET y recuperación

FROZEN — PH3 = BOOT0; NRST = RESET. S1 §§5–6. REQUIRED: red de transistores de control automático, acceso manual a BOOT0, botón o pads de RESET y acceso SWD. Topología y valores todavía TO SELECT / VERIFY.

Modo / secuencia | BOOT0 | NRST | Resultado requerido
Normal | LOW | HIGH | Arranque de aplicación según option bytes configuradas.
Entrada a bootloader | HIGH, estable antes del reset | Pulso LOW → release | System Memory / ROM bootloader.
Programación | Mantener selección de boot acordada | Liberado | USART1 permite programación de Flash.
Regreso a aplicación | LOW antes del reset | Pulso LOW → release | Inicia firmware de aplicación.

DTR ---> BOOT0 control network ---> HMI_BOOT0 / PH3
RTS ---> RESET control network ---> HMI_NRST / NRST
Manual BOOT access -------------> HMI_BOOT0
Manual RESET access -----------> HMI_NRST
SWD NRST ----------------------> HMI_NRST

REQUIRED: DTR y RTS no se conectan directamente a BOOT0/NRST. S1 advierte que DTR puede cambiar al abrir el puerto. La red debe mantener defaults inequívocos, permitir intervención manual sin contención y coexistir con NRST del debugger. Valores de pulls, transistores, polaridad eléctrica, pulso de reset y tiempos setup/hold: [VERIFY FROM DATASHEET].

## 6.1 Cierre del circuito de control

Preparar tabla completa para todas las combinaciones eléctricas DTR/RTS, incluyendo estado no enumerado, arranque, apertura/cierre de puerto, desconexión y host apagado. Distinguir estado lógico de la API Linux de tensión medida en pin: no asumir correspondencia HIGH/LOW. Demostrar que apertura normal no dispara bootloader ni deja reset permanente. Esta tabla y el esquema de transistores son REQUIRED antes del schematic freeze.

VERIFY: option bytes y condiciones de boot de U585 deben permitir seleccionar System Memory desde PH3. Definir configuración inicial mediante SWD y registrar estado de protección y acceso al bootloader. No asumir que BOOT0 HIGH funciona con cualquier configuración de option bytes. T05/T06 deben observar señales y respuesta del ROM bootloader.

## 6.2 SWD obligatorio

Señal | Conexión en J3 | Criterio
PA13 | SWDIO | Reservada; no reutilizar.
PA14 | SWCLK | Reservada; no reutilizar.
NRST | HMI_NRST | Debugger y reset manual compatibles.
3V3 | +3V3 | Referencia de tensión; no asumir alimentación desde debugger.
GND | GND | Retorno común.

J3 TO SELECT: pads/header y orden de contactos, orientación y footprint VERIFY. Debe ser accesible en la integración. SWD permite bring-up, debugging, programación, recuperación y diagnóstico aunque fallen USB, soldadura del CP2102C, option bytes, bootloader o firmware (S1 §6).

# 7 USB UART y CP2102C

FROZEN — U2 CP2102C-A01-GQFN24. S1 §§2–4 selecciona USB CDC estándar y disponibilidad de DTR/RTS en QFN24. No es CP2102N. S1 reporta QFN24 4×4 mm, hasta 3 Mbaud y buffers TX/RX de 512 bytes; verificar contra datasheet al seleccionar símbolo y footprint. Esos máximos no fijan el baud rate de Rev A.

U2 señal | Conexión | Pin físico / estado
TXD | PA10 / USART1_RX / UART1_RX | 21 según S1 §4; VERIFY
RXD | PA9 / USART1_TX / UART1_TX | 20 según S1 §4; VERIFY
DTR | Red de control BOOT0 | 23 según S1 §4; VERIFY
RTS | Red de control NRST | 19 según S1 §4; VERIFY
D+ / D− | J1 mediante ESD / USB_D+ / USB_D− | [VERIFY FROM DATASHEET]
VIO | +3V3 / referencia lógica UART | Desacoplo y restricciones [VERIFY FROM DATASHEET]
Alimentación y GND | Red conforme a configuración USB bus-powered del fabricante | Pines, regulador interno, VBUS sense, reset y capacitores [VERIFY FROM DATASHEET]

OPEN ITEM: la fuente solo congela VIO = 3.3 V; no define la alimentación completa de U2. No conectar arbitrariamente todos sus pines de alimentación a +3V3 o +5V_USB. Revisar diagrama de referencia de CP2102C-A01-GQFN24, pad expuesto, señales no usadas y configuración CDC/DTR/RTS.

## 7.1 USART1 exclusivo

CP2102C RXD <--- PA9 / USART1_TX / UART1_TX
CP2102C TXD ---> PA10 / USART1_RX / UART1_RX

REQUIRED: USART1 se reserva para comunicación normal UNO Q, firmware update y ROM bootloader. No reutilizar PA9/PA10. Son señales UART lógicas a 3.3 V, no RS-232. S1 §3 reporta 8 bits, paridad par y 1 stop bit para ROM bootloader; confirmar en documentación ST al ejecutar T05/T07. Baud rate y formato de aplicación [OPEN ITEM]; configuración de aplicación y bootloader pueden diferir.

## 7.2 USB-C USB 2.0 device-only

J1 VBUS ------> +5V_USB
J1 D+ --------> ESD ------> U2 D+
J1 D- --------> ESD ------> U2 D-
J1 CC1 -------> 5.1 kohm --> GND
J1 CC2 -------> 5.1 kohm --> GND

REQUIRED: resistencias CC independientes; no unir CC1 y CC2. ESD dedicada D+/D− cercana a J1. Verificar contactos duplicados USB 2.0 del receptáculo para operación en ambas orientaciones, sin crear stubs innecesarios. Shield: conexión/estrategia [VERIFY]; conservar red diferenciada USB_SHIELD hasta cerrar la decisión. Tratamiento de contactos no usados, protección VBUS, corriente/inrush y backfeed [VERIFY]; piezas TO SELECT. No añadir USB 3.

USB_D+/USB_D− requieren routing diferencial controlado, corto y referencia GND continua. Impedancia objetivo, tolerancias, geometría y reglas de fabricante [VERIFY]; no fijar ancho o separación sin stackup físico.

# 8 Display GC9A01

FROZEN — GC9A01 240×240 RGB565, interfaz SPI1 + DMA, write-only. MISO no requerido en implementación actual. S1 §§7 y 9.

MCU | Display | Net | Función
PA5 | SCK | TFT_SCK | SPI1 clock
PA7 | MOSI | TFT_MOSI | Datos SPI1
PB0 | CS | TFT_CS | Chip select
PB1 | DC | TFT_DC | Data / command
PB2 | RST | TFT_RST | Reset display
PB3 | BL / BL_PWM | TFT_BL_PWM | Control backlight mediante circuito verificado

## 8.1 Conector J2 y alimentación

Contacto propuesto en S1 §9 | Señal | Estado
1 | VCC | VERIFY contra módulo físico
2 | GND | VERIFY contra módulo físico
3 | SCK | VERIFY contra módulo físico
4 | MOSI | VERIFY contra módulo físico
5 | CS | VERIFY contra módulo físico
6 | DC | VERIFY contra módulo físico
7 | RST | VERIFY contra módulo físico
8 | BL | VERIFY contra módulo físico

FABRICATION GATE FG-01: el orden anterior es propuesta de S1, no pinout físico liberado. Verificar módulo exacto, fabricante/modelo, conector, número de contactos, paso, orientación, numeración, foto y ficha técnica. El conector puede dibujarse inicialmente como interfaz lógica; su footprint no se libera hasta cerrar FG-01.

VERIFY: VCC admisible del módulo, compatibilidad lógica 3.3 V, consumo máximo y backlight. La rama desde VBUS en S1 está condicionada por el módulo; no aplicar 5 V al controlador desnudo por inferencia. Red TFT_VCC y ruta final [OPEN ITEM].

## 8.2 Backlight y SPI

REQUIRED: PB3 proporciona control PWM, no una alimentación LED validada. Determinar si BL es entrada lógica o nodo de potencia; seleccionar transistor/driver y limitación de corriente solo si lo exige el módulo. Polaridad, corriente, tensión, estado al reset y frecuencia PWM [VERIFY]. No alimentar un backlight directamente desde PB3 sin evidencia de compatibilidad.

SPI clock máximo y configuración de modo, tiempos CS/DC/RST, secuencia de inicialización y reset: [VERIFY FROM DATASHEET] del módulo/controlador exacto. Reservar recursos DMA y buffers adecuados; confirmar acceso DMA a memoria y coherencia requerida por el firmware. No congelar frecuencia SPI, FPS ni cantidad de buffers que la fuente no especifica.

T09 debe comprobar inicialización, color RGB565, orientación y backlight; T10 debe registrar resultado de cada una de las 9 pantallas existentes. Lista/nombres de pantallas: [OPEN ITEM], obtener del proyecto actual sin inventarlos.

# 9 Organización del esquemático KiCad

Sheet | Contenido REQUIRED | Interfaces
Sheet 01 — POWER | USB VBUS, protección necesaria, 5 V, LDO 3.3 V, bulk, decoupling, power flags. | +5V_USB / +3V3 / GND / TFT_VCC
Sheet 02 — USB-UART | USB-C, CC1, CC2, D+, D−, ESD, CP2102C, TXD, RXD, DTR, RTS. | USB_D+ / USB_D− / UART1_TX / UART1_RX / USB_DTR / USB_RTS
Sheet 03 — MCU | STM32U585CIT6, VDD, VSS, VDDA, VCAP, clock, NRST, BOOT0, USART1, SPI1, GPIOs; red de auto-boot/reset. | HMI_BOOT0 / HMI_NRST / SWD / TFT signals
Sheet 04 — DISPLAY | Conector GC9A01, SCK, MOSI, CS, DC, RST, BL, power, GND; control backlight. | TFT signals / TFT_VCC / GND
Sheet 05 — DEBUG | SWDIO, SWCLK, NRST, 3V3, GND, BOOT0 access, RESET access. | SWDIO / SWCLK / HMI_NRST / HMI_BOOT0

Mantener una sola instancia de cada componente. J1 pertenece a USB-UART; POWER recibe VBUS por net. Desacoplos locales pueden colocarse junto a U1/U2 en su sheet, con ownership documentado en POWER. DEBUG contiene acceso manual; MCU contiene la red automática. No duplicar switches, pulls o regulador entre hojas.

## 9.1 Nombres de red y sentido

Nets | Convención / uso
+5V_USB / +3V3 / GND | Rails comunes inequívocos.
USB_D+ / USB_D− | Par entre J1, ESD y U2.
UART1_TX / UART1_RX | Sentido referido al STM32: TX sale PA9; RX entra PA10.
USB_DTR / USB_RTS | Salidas U2 hacia redes de control.
HMI_BOOT0 / HMI_NRST | Salida de redes de control hacia U1 y acceso manual.
SWDIO / SWCLK | U1 a J3.
TFT_SCK / TFT_MOSI / TFT_CS | Bus y selección de display.
TFT_DC / TFT_RST / TFT_BL_PWM | Control display y backlight.
TFT_VCC / MCU_VDDA / MCU_VCAP | Redes locales de supply; conexiones finales VERIFY.
USB_SHIELD | Shield hasta cerrar estrategia de conexión.

REQUIRED: evitar TX, RX, DATA, SIGNAL1 y LCD1 como nombres aislados. Marcar NC solo tras auditar función del pin. Power flags representan fuentes reales y no deben ocultar un error de alimentación o dos fuentes en conflicto. Etiquetas jerárquicas y tipos eléctricos deben permitir ERC útil.

# 10 Requisitos de PCB

ID | Requisito | Verificación / cierre
PCB-01 | FROZEN: 4 capas; L1 components + signals; L2 solid GND; L3 3V3 / 5V + low-speed signals; L4 signals. | Stackup con fabricante; espesores [OPEN ITEM].
PCB-02 | L2 continuo bajo USB y señales rápidas; no cruzar cortes de referencia. | Revisión de planos y retornos.
PCB-03 | USB diferencial corto, controlado; ESD junto a J1; evitar stubs. | Reglas físicas e impedancia [VERIFY]; DRC y revisión.
PCB-04 | Retornos SPI continuos; SCK/MOSI cortos y alejados de nodos sensibles. | Revisión J2 y referencia; velocidad SPI VERIFY.
PCB-05 | Desacoplos cerca de cada pin; retorno corto a GND; VCAP junto a U1. | Revisión placement contra ST.
PCB-06 | Distribuir potencia según corriente real y disipación del LDO. | Anchos, cobre y thermal design [VERIFY].
PCB-07 | Ubicar U2 junto al bloque USB y U1 según rutas display/debug. | Revisión de conexiones y EMI; evitar lazos grandes.
PCB-08 | J1/J2 según mecánica y módulo exacto; SWD/RESET/BOOT0 accesibles. | Verificación física y orientación de conectores.
PCB-09 | No fijar dimensiones finales de PCB sin cierre mecánico. | Dimensiones, mounting y keepouts [OPEN ITEM].

No fijar longitudes, skew, anchos, resistencias serie ni separaciones por suposición. Cerrar reglas con documentación de componentes, stackup y fabricante. Si se enrutan señales rápidas en L4, demostrar retorno continuo a la referencia correspondiente; L3 no garantiza por sí sola un plano de GND.

# 11 Actualización de firmware

UNO Q / Debian [firmware.bin]
| STM32_Programmer_CLI / /dev/ttyACM*
v
CP2102C [USB CDC]
| USART1 PA9 / PA10
v
STM32 ROM bootloader --> Internal Flash
DTR --> BOOT0 control | RTS --> NRST control

Objetivo Rev A: STM32_Programmer_CLI desde Linux/Debian. La arquitectura soporta esta ruta según S1 §§3 y 14; no está físicamente validada para este conjunto. /dev/ttyACM* es el nodo previsto, no un nombre fijo verificado. Identificar dispositivo real y evitar seleccionar otro puerto por wildcard.

Secuencia REQUIRED: detener comunicación de aplicación; seleccionar puerto/configuración ROM; BOOT0 HIGH; pulso NRST LOW y release; conectar bootloader; programar firmware.bin en dirección validada por mapa de memoria; verificar; BOOT0 LOW y reset; confirmar aplicación y reanudar protocolo. Parámetros CLI, dirección Flash, baud rate y tiempos [VERIFY]. No publicar comando ejecutable con valores supuestos.

FG-03 debe ejecutar el binario CLI compatible con la plataforma QRB2210/Debian real, documentar versión/instalación/arquitectura de CPU, control de líneas, log de programación y verificación, y regreso a aplicación. El wrapper solips-hmi-update es futuro, no entregable ya probado.

# 12 Bring-up y criterios de verificación

Todas las pruebas están PLANNED / pendientes de ejecución en Rev A. Registrar board serial/revisión, firmware, instrumentos, fecha, responsable, evidencia y resultado PASS/FAIL. Los límites no provistos deben cerrarse contra datasheets antes de declarar PASS.

ID | Prueba | Criterio de éxito | Trazabilidad
T01 | Power only | 5 V y 3.3 V correctos; sin corto, con carga prevista y temperatura admisible. | ER-01/02/05 / U3 / U1
T02 | USB enumeration | CP2102C aparece en Debian; CDC y nodo identificados; ambas orientaciones USB-C. | ER-04 / FG-02 / U2
T03 | UART | Comunicación MCU ↔ CP2102C sin error en prueba definida. | ER-03 / PA9 / PA10
T04 | SWD | Debugger detecta STM32; programación y recuperación verificadas. | FR-09 / J3
T05 | Manual bootloader | BOOT0 manual + reset dan respuesta ROM por USART1. | FR-08/11 / PH3 / NRST
T06 | Auto boot | DTR/RTS ejecutan entrada/salida; abrir puerto normal conserva aplicación. | FR-10 / redes control
T07 | CLI flashing | Firmware se programa y verifica desde UNO Q; log y señales registrados. | FR-08 / FG-03
T08 | Application boot | BOOT0 LOW + reset inicia firmware y HMI. | FR-01 / U1
T09 | GC9A01 | Display inicializa; RGB565/SPI1/DMA y backlight funcionan. | FR-06/12 / FG-01 / J2
T10 | HMI | Las 9 pantallas y transiciones funcionan; build LVGL 9.5 y UIManager. | FR-04/05/07
T11 | Host protocol | Mensajes semánticos actualizan VehicleState y UI esperados. | FR-02/03 / UART1

Comenzar con inspección y prueba de cortos antes de energizar. Verificar T01 antes de habilitar display/backlight; T04 puede hacerse antes de T03 para cargar firmware mínimo. No utilizar el bring-up de la PCB final como sustituto de las pruebas previas exigidas por FG-02/FG-03.

## 12.1 Evidencia de firmware

T10: inventario de 9 pantallas obtenido del firmware existente, captura y resultado individual; memoria Flash/SRAM de build dedicado; assets residentes en MCU; ausencia de render en host. T11: tabla mensaje → campo VehicleState → pantalla/indicador; incluir recepción parcial o inválida según protocolo final. Rendimiento mínimo, timeout y comportamiento ante host ausente [OPEN ITEM]; no declarar umbrales inventados.

# 13 Open items y fabricación

ID | Pendiente | Cierre requerido
OI-01 | Clock y RTC | Fuente, árbol y circuitos antes de schematic freeze.
OI-02 | Power MCU y terminales | Datasheet/revisión; valores de bulk, VCAP, todos los dominios y pinout antes de freeze.
OI-03 | Power/configuración CP2102C | Esquema fabricante, VIO, VBUS, pad y pines antes de freeze.
OI-04 | Auto-boot/reset | Topología, tabla lógica, valores, tiempos y option bytes antes de freeze.
OI-05 | LDO/protecciones/ESD/shield | Selección, ratings, corriente y térmica antes de revisión de componentes.
OI-06 | Display físico y backlight | Cerrar FG-01 antes de liberar conector/power/layout.
OI-07 | Host CDC y CLI real | Cerrar FG-02/03 antes de fabricación.
OI-08 | Protocolo y firmware | Formato, baud, unidades, timeout, buffers, lista de 9 pantallas; no bloquea iniciar KiCad.
OI-09 | Mecánica y stackup físico | Enclosure no bloquea esquema; dimensiones/keepouts y reglas antes de layout final.

## 13.1 Qué no bloquea empezar KiCad

S1 Design freeze permite comenzar sin protocolo final, mensajes CAN, lógica del vehículo, enclosure ni futuras pantallas. Los tres gates también pueden quedar pendientes mientras se dibujan bloques y conexiones reservadas. Los OPEN ITEM deben figurar en el registro de revisión; no ocultarlos con valores provisionales que parezcan liberados.

## 13.2 Gates principales explícitos de S1

Gate | Verificación obligatoria antes de fabricar | Evidencia de cierre
FG-01 | GC9A01 físico exacto: módulo, conector y pinout; confirmar supply y BL aplicables. | Modelo/ficha/foto, tabla contacto-net, orientación y footprint revisados.
FG-02 | CP2102C en Debian del UNO Q: enumeración, device node, comunicación. | Hardware representativo con CP2102C exacto; logs USB/CDC y prueba UART.
FG-03 | STM32_Programmer_CLI real: USART1, DTR, RTS, ROM bootloader, programación/verificación. | Setup representativo U585 + CP2102C + red control; versión CLI, logs y captura BOOT0/NRST.

S1 establece solo estos tres gates principales; no añade otros gates explícitos. Las comprobaciones de datasheet, alimentación, option bytes, footprint, ERC/DRC e integración USB son cierres de ingeniería/revisión necesarios. No son pruebas ya superadas ni autorizan fabricación con pendientes críticos. FG-02/03 deben probarse con hardware representativo antes del pedido de Rev A; no presumir que dispositivos distintos prueban esta implementación.

# 14 BOM preliminar

Reference | Component | Function | Status
U1 | STM32U585CIT6 | MCU HMI | FROZEN; símbolo/footprint VERIFY
U2 | CP2102C-A01-GQFN24 | USB CDC ↔ UART + DTR/RTS | FROZEN; símbolo/footprint VERIFY
U3 | 3.3 V LDO ≥500 mA | Regulación desde USB | TO SELECT; térmica VERIFY
J1 | USB-C receptacle USB 2.0 | Entrada power/data device-only | TO SELECT
J2 | GC9A01 connector | Interfaz display | TO SELECT; FG-01
J3 | SWD pads/header | Programación/debug/recovery | TO SELECT; pinout VERIFY
D_ESD* | ESD network D+/D− | Protección USB | TO SELECT; ratings VERIFY
Q_BOOT* / R_BOOT* | BOOT0 control network | DTR a PH3; default LOW | TO SELECT; topología VERIFY
Q_RST* / R_RST* | RESET control network | RTS a NRST; reset seguro | TO SELECT; topología VERIFY
SW_BOOT* / TP_BOOT* | Acceso BOOT0 manual | Entrada manual al ROM | TO SELECT
SW_RESET* / TP_RESET* | RESET access | Reset manual | TO SELECT
C_VDD* | 100 nF por alimentación | Desacoplo MCU | Valor S1 §8; cantidad/rating VERIFY
C_VDDA* | 100 nF + 1 µF | Desacoplo analógico | Valor S1 §8; rating VERIFY
C_VCAP* | 4.7 µF o 2×2.2 µF | Estabilidad regulator MCU | VERIFY FROM DATASHEET; opción final abierta
C_BULK* | Bulk capacitors | Reservas en rails / MCU | TO SELECT; valor VERIFY
C_U2* / C_U3* | Capacitores locales | Bridge y estabilidad LDO | TO SELECT; datasheets VERIFY
R_PULL* | Pull resistors | Defaults de control | TO SELECT; valor VERIFY
R_CC1 / R_CC2 | 5.1 kΩ, dos independientes | USB-C CC a GND | Valor FROZEN; tolerancia/rating VERIFY
Q_BL* / R_BL* | Red BL si módulo lo requiere | Potencia/control backlight | TO SELECT / VERIFY por FG-01
PROT_VBUS* | Protección VBUS por definir | Entrada USB | VERIFY necesidad y selección

Referencias con * son grupos provisionales, no designadores finales ni cantidades liberadas. Asignar R/C/Q/TP únicos al capturar el circuito. No hay números de parte seleccionados para pasivos, ESD, LDO o conectores. No usar sustituciones de U1/U2 sin control de cambio de la baseline.

# 15 Definition of Done del esquemático

Checklist REQUIRED para revisión: cada punto debe tener responsable y evidencia. Ready for schematic review no equivale a fabricación autorizada; los gates pueden estar documentados como pendientes, pero deben cerrarse para fabricar.

☐ Arquitectura completa y decisiones FROZEN preservadas

☐ USB-C device-only y receptáculo auditado

☐ CP2102C-A01-GQFN24 exacto y alimentación verificada

☐ D+/D− conectados con orientación USB-C verificada

☐ ESD definida y componentes revisados

☐ CC1/CC2 con 5.1 kΩ independientes a GND

☐ USART1 PA9/PA10 exclusivo y TX/RX cruzados correctamente

☐ STM32 power completo para CIT6 LQFP48

☐ VDDA y retorno analógico verificados

☐ VCAP y características de capacitores cerrados

☐ Clock cerrado; RTC definido o explícitamente no requerido

☐ NRST con control manual y debugger compatible

☐ BOOT0 con default LOW y acceso manual

☐ DTR/RTS control con topología, tabla lógica y tiempos documentados

☐ SWD con PA13, PA14, NRST, 3V3 y GND accesibles

☐ SPI1 PA5/PA7 + DMA reservados

☐ GC9A01 y conector ligados a FG-01

☐ Backlight PB3 con control eléctrico seguro

☐ Power tree y presupuesto de corriente/térmica revisados

☐ Decoupling y bulk con valores/referencias/rating verificados

☐ Net names consistentes en las cinco sheets

☐ ERC sin errores no justificados; excepciones documentadas

☐ Revisión de componentes y ratings completada

☐ Revisión de pinout/símbolo/footprint y orientación documentada

☐ Gates FG-01/02/03 documentados con evidencia o bloqueo explícito

# 16 Siguiente paso

Una vez aprobada esta baseline, no se hace otra ronda de arquitectura. Los OPEN ITEM se cierran dentro de la implementación, respetando U1/U2, USB CDC, USART1, SPI1, GC9A01 y cuatro capas. Un cambio real requiere revisión explícita de baseline y trazabilidad de impacto.

Engineering Requirements -> KiCad Schematic -> ERC
-> Schematic Review -> Component / Footprint Verification
-> PCB Layout -> DRC -> Manufacturing Review -> Gerbers
-> Fabrication -> Bring-up

Acción inmediata: crear exactamente las cinco sheets; capturar USB-C + CP2102C, auto-boot/reset, MCU, power, SWD y display; cerrar verificaciones de datasheet antes del schematic freeze. Liberar fabricación solo con gates PASS y revisión de fabricación completada.

SOLIPS HMI CONTROLLER REV A | v1.0 |
