ferrglez/solips-hmi-controller/SOLIPS_HMI_CONTROLLER_REV_A/SOLIPS_HMI_CONTROLLER_REV_A.kicad_pcb

## KiCad design SOLIPS_HMI_CONTROLLER_REV_A/SOLIPS_HMI_CONTROLLER_REV_A.kicad_pcb (2026-10-21)

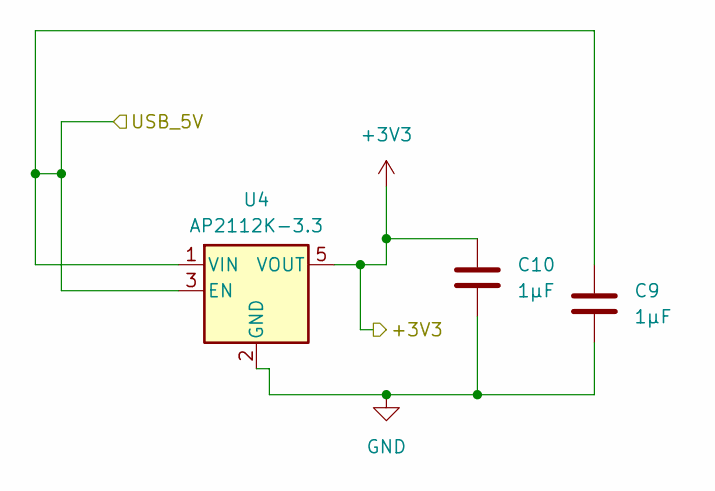
[picture p1: schematic 01_POWER.kicad_sch]

Parts:
C9, C10: 1µF; C_0805_2012Metric
U4: AP2112K-3.3; SOT-23-5

Connections:
+3V3: C10.1, U4.5 (VOUT); also elsewhere on the board
/02_USB_UART/USB_5V: C9.1, U4.1 (VIN), U4.3 (EN); also elsewhere on the board
GND: C9.2, C10.2, U4.2 (GND); also elsewhere on the board

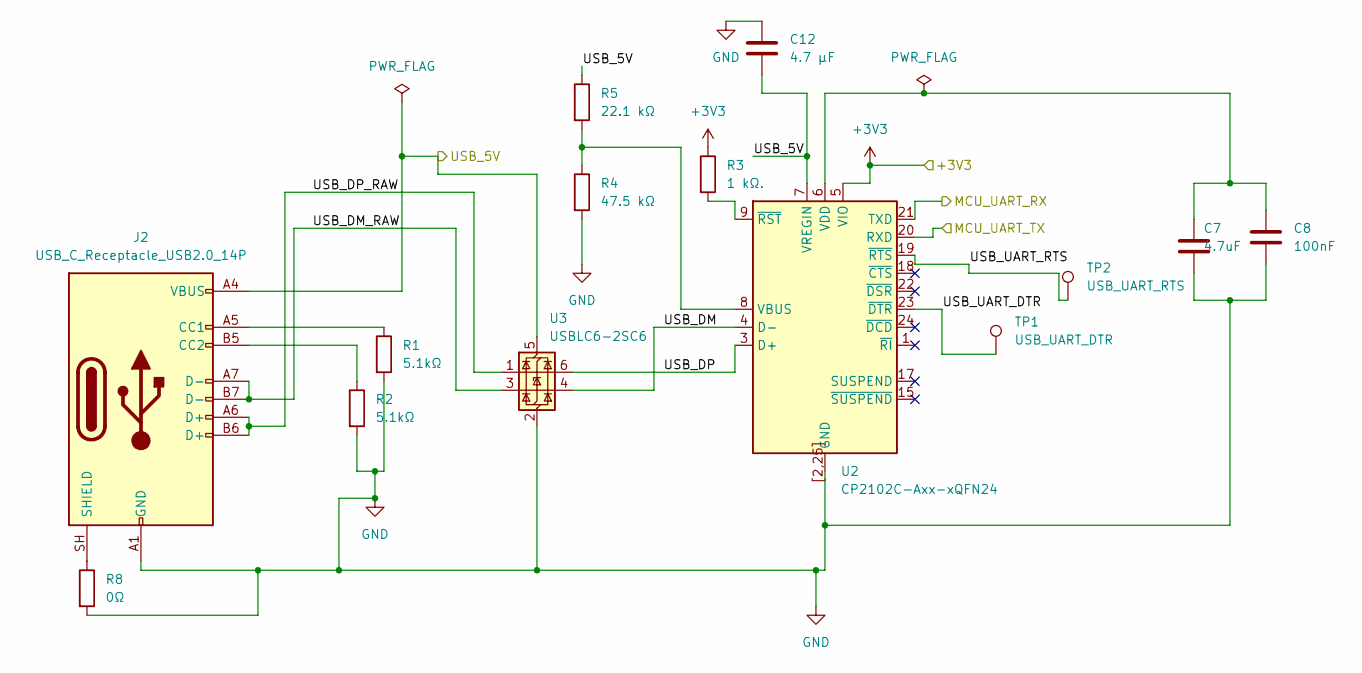
[picture p2: schematic 02_USB_UART.kicad_sch]

Parts:
C7: 4.7uF; C_0805_2012Metric
C8: 100nF; C_0603_1608Metric
C12: 4.7 µF; C_0805_2012Metric
J2: USB_C_Receptacle_USB2.0_14P; USB_C_Receptacle_Amphenol_124019772112A
R1, R2: 5.1kΩ; R_0603_1608Metric
R3: 1 kΩ.; R_0603_1608Metric
R4: 47.5 kΩ; R_0603_1608Metric
R5: 22.1 kΩ; R_0603_1608Metric
R8: 0Ω; R_0603_1608Metric
TP1: USB_UART_DTR; TestPoint_Pad_D1.5mm
TP2: USB_UART_RTS; TestPoint_Pad_D1.5mm
U2: CP2102C-Axx-xQFN24; WQFN-24-1EP_4x4mm_P0.5mm_EP2.45x2.45mm
U3: USBLC6-2SC6; SOT-23-6

Connections:
+3V3: R3.1, U2.5 (VIO); also elsewhere on the board
/02_USB_UART/MCU_UART_RX: U2.21 (TXD); also elsewhere on the board
/02_USB_UART/MCU_UART_TX: U2.20 (RXD); also elsewhere on the board
/02_USB_UART/USB_5V: C12.2, J2.A4 (VBUS), J2.A9 (VBUS), J2.B4 (VBUS), J2.B9 (VBUS), R5.1, U2.7 (VREGIN), U3.5 (VBUS); also elsewhere on the board
/02_USB_UART/USB_DM: U2.4 (D-), U3.4 (I/O2)
/02_USB_UART/USB_DM_RAW: J2.A7 (D-), J2.B7 (D-), U3.3 (I/O2); also elsewhere on the board
/02_USB_UART/USB_DP: U2.3 (D+), U3.6 (I/O1)
/02_USB_UART/USB_DP_RAW: J2.A6 (D+), J2.B6 (D+), U3.1 (I/O1); also elsewhere on the board
/02_USB_UART/USB_UART_DTR: TP1.1 (1_1), U2.23 (~DTR)
/02_USB_UART/USB_UART_RTS: TP2.1 (1_1), U2.19 (~RTS)
GND: C7.2, C8.2, C12.1, J2.A1 (GND), J2.A12 (GND), J2.B1 (GND), J2.B12 (GND), R1.2, R2.2, R4.2, R8.2, U2.2 (GND), U2.25 (GND), U2.[2,25] (GND), U3.2 (GND); also elsewhere on the board
unnamed 19: J2.A5 (CC1), R1.1; also elsewhere on the board
unnamed 20: J2.B5 (CC2), R2.1; also elsewhere on the board
unnamed 21: J2.SH (SHIELD), R8.1; also elsewhere on the board
unnamed: R4.1, R5.2, U2.8 (VBUS)
unnamed: C7.1, C8.1, U2.6 (VDD)
unnamed: R3.2, U2.9 (~RST)

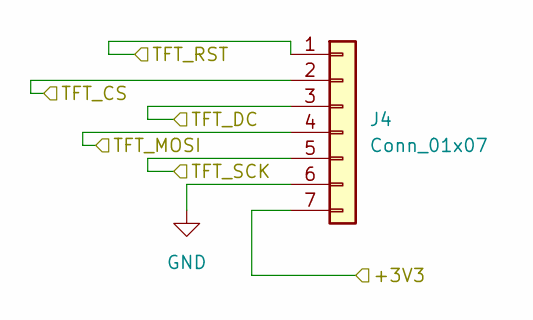
[picture p3: schematic 04_DISPLAY.kicad_sch]

Parts:
J4: Conn_01x07; PinHeader_1x07_P2.54mm_Vertical

Connections:
+3V3: J4.7; also elsewhere on the board
/03_MCu/TFT_CS: J4.2; also elsewhere on the board
/03_MCu/TFT_DC: J4.3; also elsewhere on the board
/03_MCu/TFT_MOSI: J4.4; also elsewhere on the board
/03_MCu/TFT_RST: J4.1; also elsewhere on the board
/03_MCu/TFT_SCK: J4.5; also elsewhere on the board
GND: J4.6; also elsewhere on the board

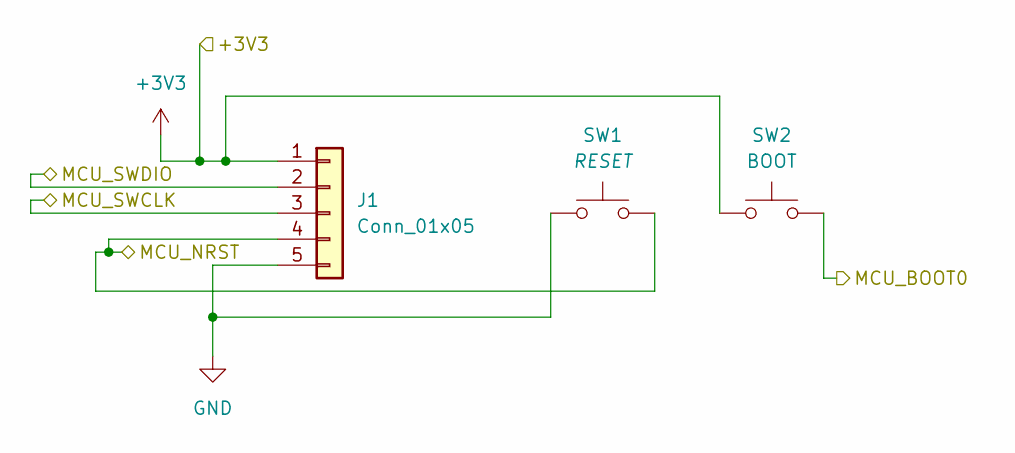
[picture p4: schematic 05_DEBUG.kicad_sch]

Parts:
J1: Conn_01x05; PinHeader_1x05_P2.54mm_Vertical
SW1: RESET; SW_SPST_TL3305A
SW2: BOOT; SW_SPST_TL3305A

Connections:
+3V3: J1.1, SW2.1; also elsewhere on the board
/03_MCu/MCU_BOOT0: SW2.2; also elsewhere on the board
/03_MCu/MCU_NRST: J1.3, J1.4, SW1.2; also elsewhere on the board
/03_MCu/MCU_SWDIO: J1.2; also elsewhere on the board
GND: J1.5, SW1.1; also elsewhere on the board

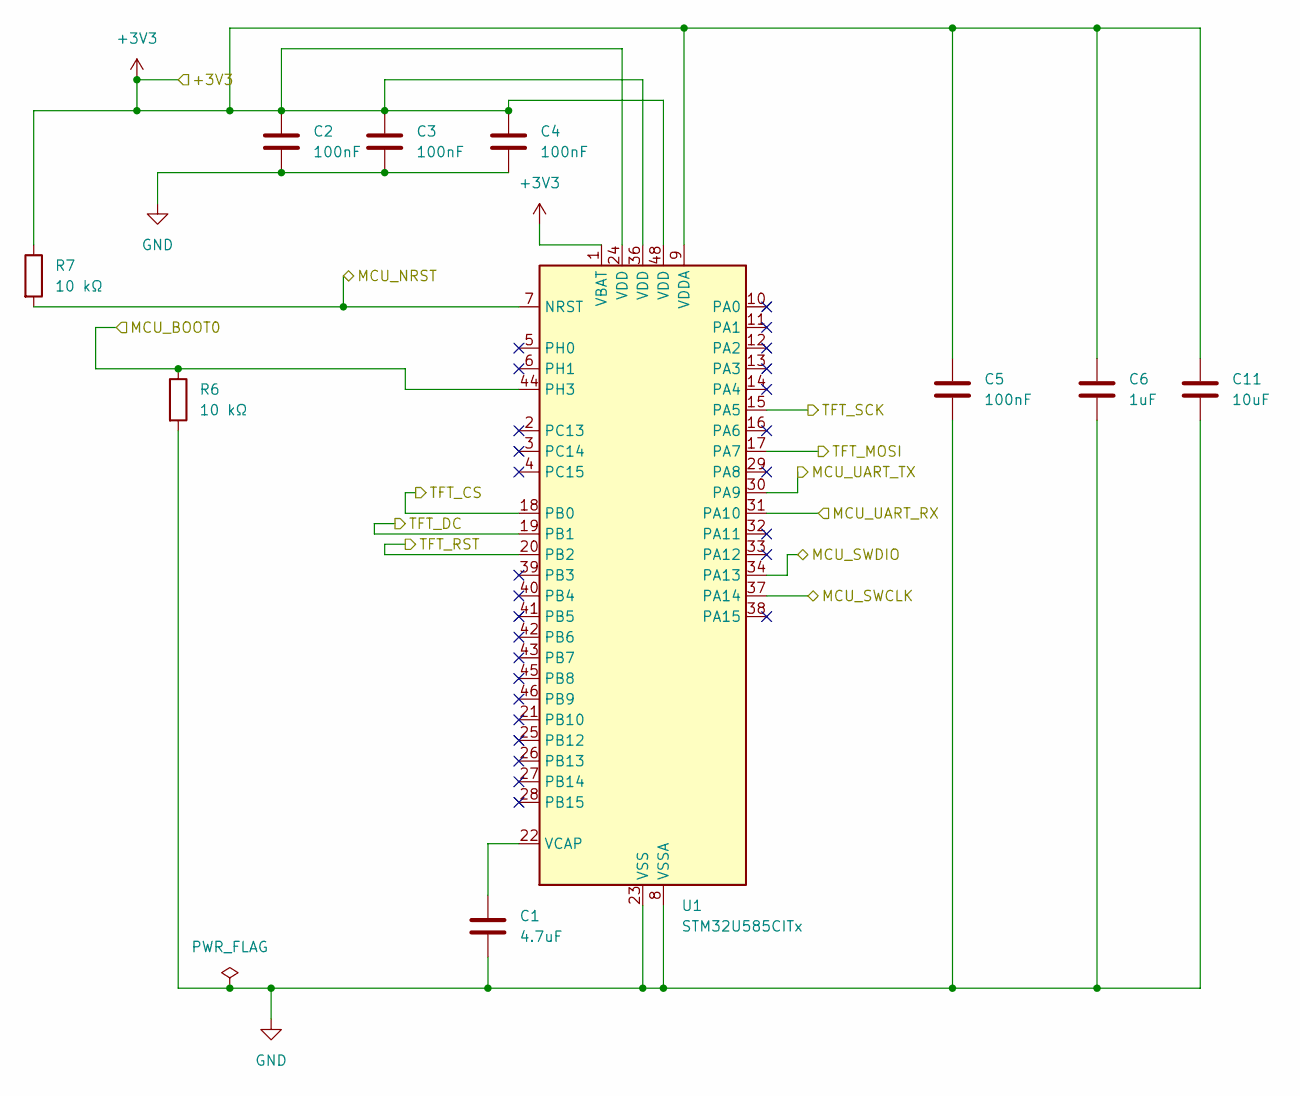
[picture p5: schematic 03_MCU.kicad_sch]

Parts:
C1: 4.7uF; C_0805_2012Metric
C2, C3, C4, C5: 100nF; C_0603_1608Metric
C6: 1uF; C_0805_2012Metric
C11: 10uF; C_1206_3216Metric
R6, R7: 10 kΩ; R_0603_1608Metric
U1: STM32U585CITx; LQFP-48_7x7mm_P0.5mm

Connections:
+3V3: C2.1, C3.1, C4.1, C5.1, C6.1, C11.1, R7.1, U1.1 (VBAT), U1.9 (VDDA), U1.24 (VDD), U1.36 (VDD), U1.48 (VDD); also elsewhere on the board
/02_USB_UART/MCU_UART_RX: U1.31 (PA10); also elsewhere on the board
/02_USB_UART/MCU_UART_TX: U1.30 (PA9); also elsewhere on the board
/03_MCu/MCU_BOOT0: R6.1, U1.44 (PH3); also elsewhere on the board
/03_MCu/MCU_NRST: R7.2, U1.7 (NRST), U1.37 (PA14); also elsewhere on the board
/03_MCu/MCU_SWDIO: U1.34 (PA13); also elsewhere on the board
/03_MCu/TFT_CS: U1.18 (PB0); also elsewhere on the board
/03_MCu/TFT_DC: U1.19 (PB1); also elsewhere on the board
/03_MCu/TFT_MOSI: U1.17 (PA7); also elsewhere on the board
/03_MCu/TFT_RST: U1.20 (PB2); also elsewhere on the board
/03_MCu/TFT_SCK: U1.15 (PA5); also elsewhere on the board
GND: C1.2, C2.2, C3.2, C4.2, C5.2, C6.2, C11.2, R6.2, U1.8 (VSSA), U1.23 (VSS), U1.35 (VSS), U1.47 (VSS); also elsewhere on the board
unnamed: C1.1, U1.22 (VCAP)

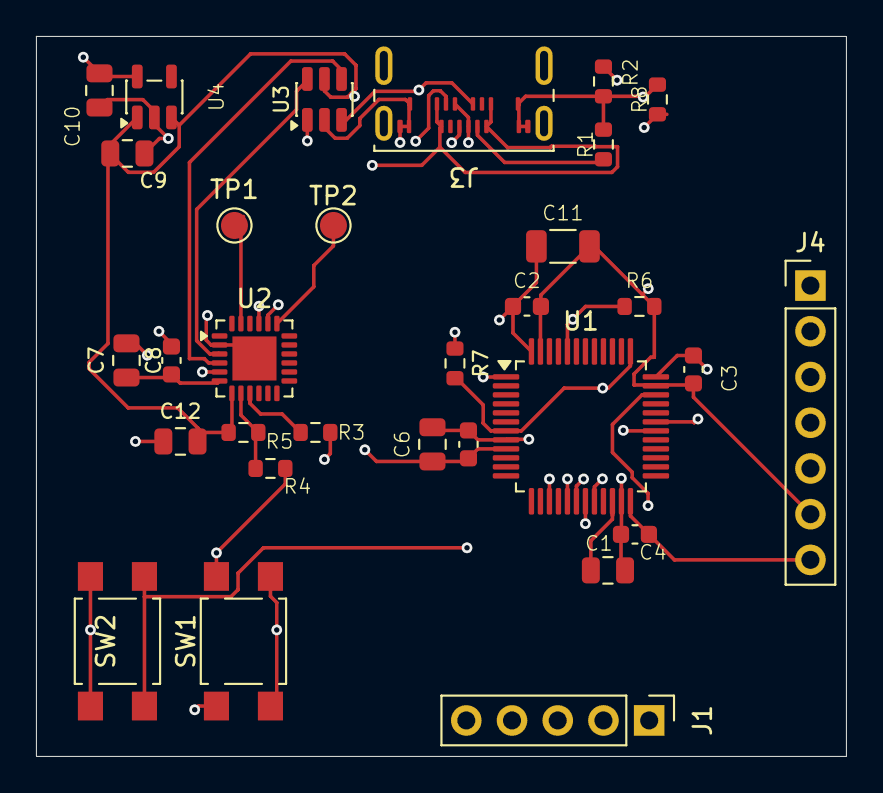
[picture p6: board SOLIPS_HMI_CONTROLLER_REV_A.kicad_pcb from above]

Board: 4 copper layers, 45.0 x 40.0 mm, 31 parts (0 on the bottom side), 26 nets.

Other parts of the board:
J3: USB_C_Receptacle_USB2.0_16P; USB_C_Receptacle_Amphenol_124019772112A

Their connections:
/02_USB_UART/USB_5V: J3.A4 (VBUS), J3.A9 (VBUS), J3.B4 (VBUS), J3.B9 (VBUS); also elsewhere on the board
/02_USB_UART/USB_DM_RAW: J3.A7 (D-), J3.B7 (D-); also elsewhere on the board
/02_USB_UART/USB_DP_RAW: J3.A6 (D+), J3.B6 (D+); also elsewhere on the board
GND: J3.A1 (GND), J3.A12 (GND), J3.B1 (GND), J3.B12 (GND); also elsewhere on the board
unnamed 19: J3.A5 (CC1); also elsewhere on the board
unnamed 20: J3.B5 (CC2); also elsewhere on the board
unnamed 21: J3.SH (SHIELD); also elsewhere on the board
