ferrglez/solips-hmi-controller/(commit log)

2026-10-21 Initial KiCad hardware design - Rev A
    [01_POWER.kicad_sch, 02_USB_UART.kicad_sch, 03_MCU.kicad_sch, 04_DISPLAY.kicad_sch, 05_DEBUG.kicad_sch, SOLIPS_HMI_CONTROLLER_REV_A.dsn, SOLIPS_HMI_CONTROLLER_REV_A.kicad_pcb, SOLIPS_HMI_CONTROLLER_REV_A.kicad_sch]
2026-10-21 chore: clean repository and keep main KiCad project
    [01_POWER.kicad_sch, 02_USB_UART.kicad_sch, 03_MCU.kicad_sch, 04_DISPLAY.kicad_sch, 05_DEBUG.kicad_sch, SOLIPS_HMI_CONTROLLER_REV_A.dsn, SOLIPS_HMI_CONTROLLER_REV_A.kicad_pcb, SOLIPS_HMI_CONTROLLER_REV_A.kicad_sch]
